Msg287/Pip-Robot/images/README.md

Pip Robot Images

This folder contains photos documenting the development, hardware setup, and interactive features of Pip, my Arduino-based robot.

Interactive Features:
- pip-front.jpeg: Pip's welcome display, showing its eyes and inviting users to interact.
- pip-game-prompt.jpeg: LCD instructions for starting the distance-matching game.
- pip-game.jpeg: Distance game in progress, displaying the target distance, measured distance, and remaining time.
- pip-personal-space.jpeg: Pip's reaction when an object is detected within 10 cm, displaying a personal space warning.

Hardware and Development:
- pip-lcd-test.jpeg: Initial testing of the LCD display and Arduino connections before assembling the robot.
- pip-wiring.jpeg: Internal hardware setup showing the Arduino, breadboard, wiring connections, power components, and servo-mounted ultrasonic sensor.
