Msg287/Pip-Robot/images/pip-lcd-test.jpeg

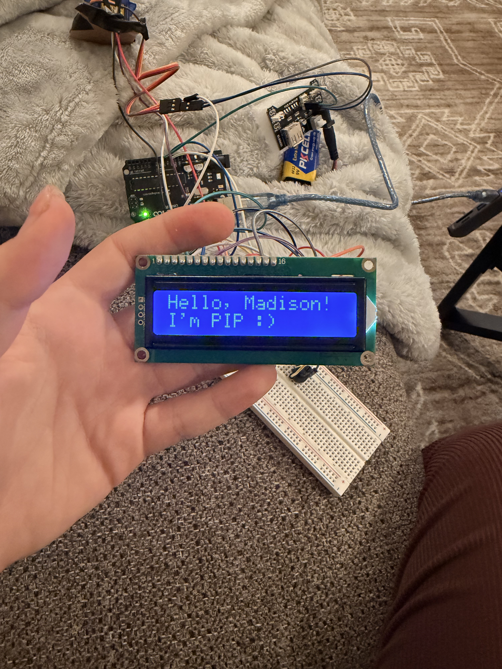
images/pip-lcd-test.jpeg
