Msg287/Pip-Robot/images/pip-front.jpeg

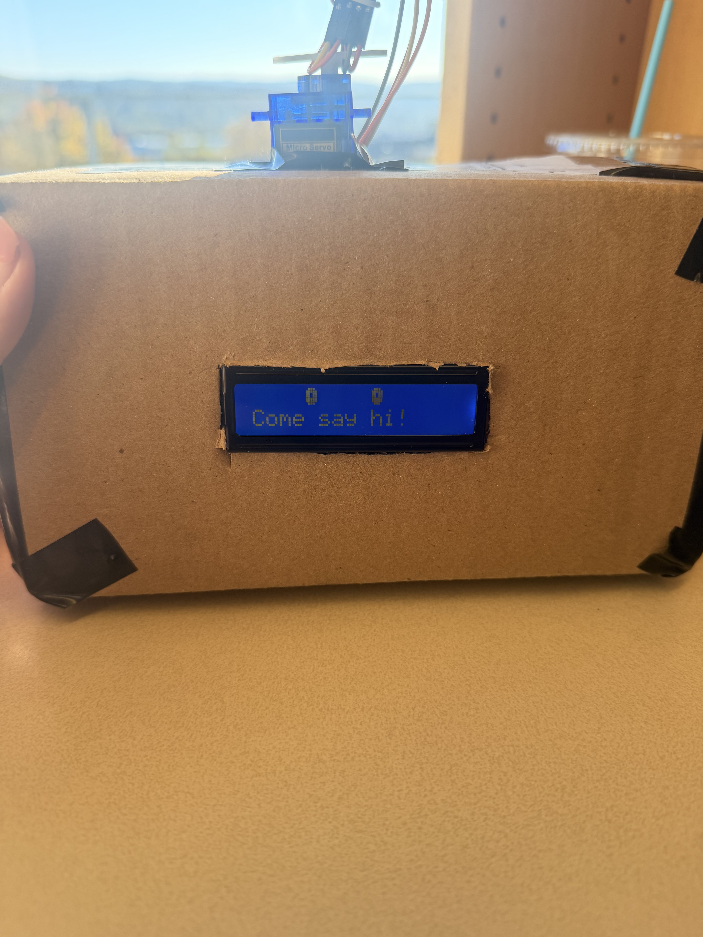
images/pip-front.jpeg
