Msg287/Pip-Robot/images/pip-wiring.jpeg

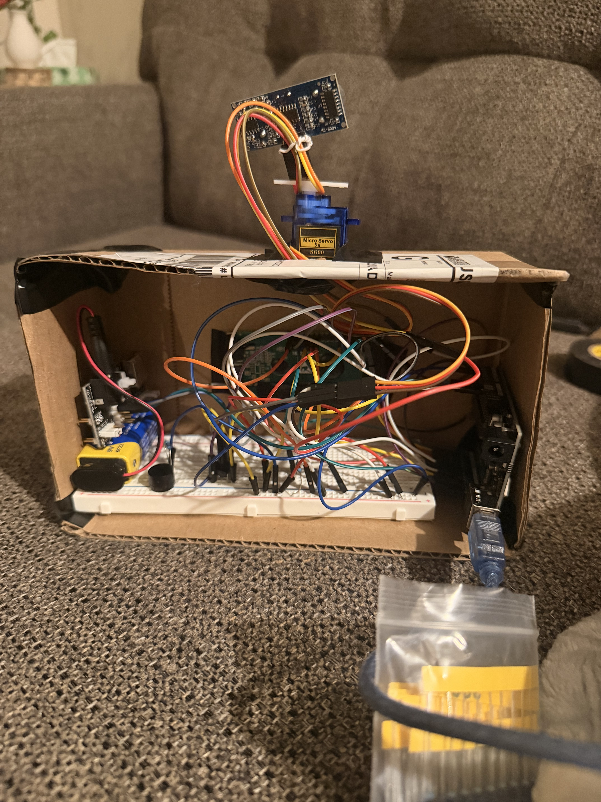
images/pip-wiring.jpeg
