Msg287/Pip-Robot/images/pip-game.jpeg

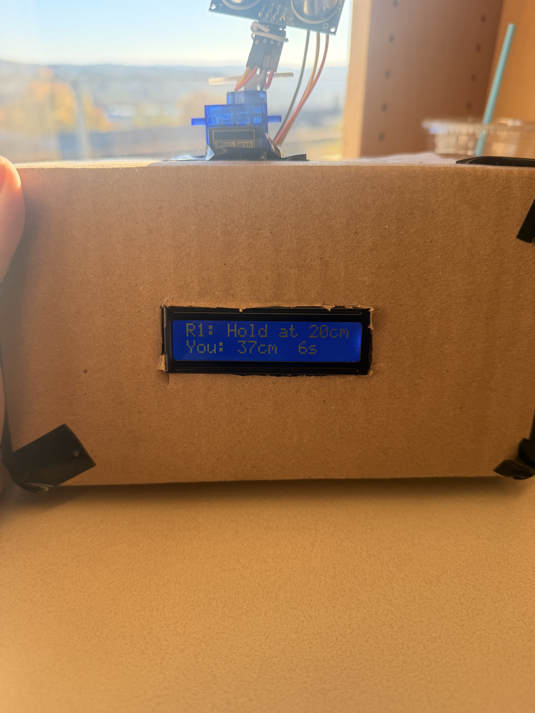
[picture p1: images/pip-game.jpeg]
images/pip-game.jpeg
